shbutkhuzi/tank_volume_reporter/README.md

# Tank Volume Reporter
Device that tracks volume, temperature and the rate of change of volume in the tank and reports it via SMS

Repository contains two main directories

- Hardware
- Software

## Hardware

This directory describes hardware used in this project.

## Software

This directory contains two directories, one for bootloader and another for main application code. Each of them are described in their respective `README.md` files.
