shbutkhuzi/tank_volume_reporter/hardware/README.md

# Hardware

Following are main components of the hardware:

- STM32F103B8T6
> Microcontroller. **Note:** Board used here is Blue Pill, but the microcontroller is replaced with 128Kb version (B8T6)
- SIM800L
> GSM/GPRS module used for communication
- 24C32B
> EEPROM IC
- A02YYUW
> Ultrasonic distance sensor
- DS18B20
> Temperature sensor
- TP4056
> Lithium battery charing module
- MT3608
> DC-DC step up converter
- 18650 Lipo battery
> Just battery

## Photos of the module
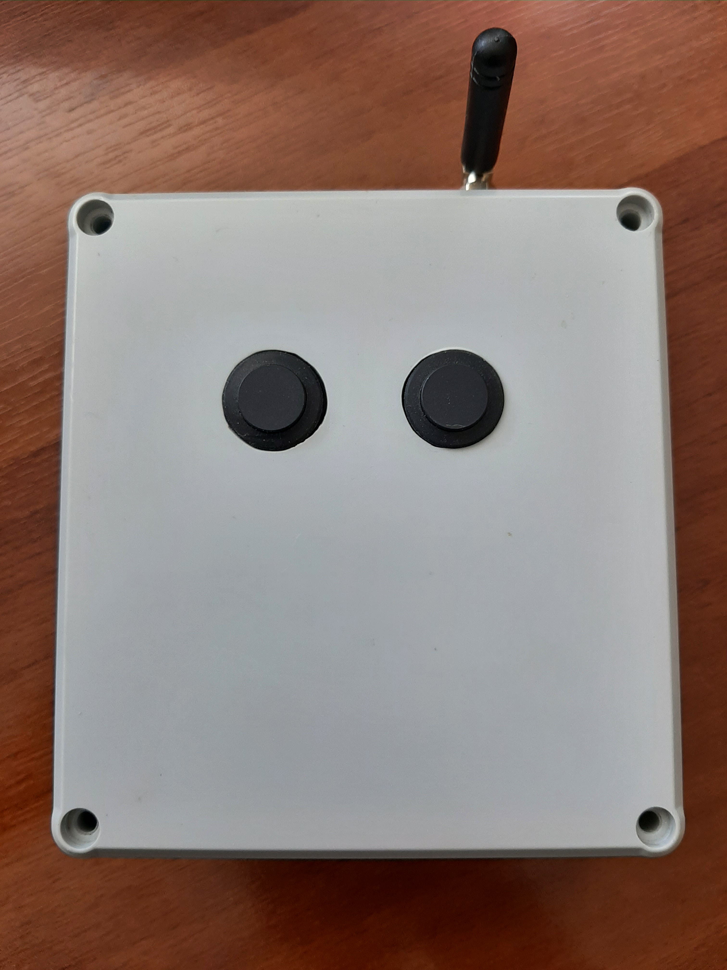
[picture p1: hardware/image_1.jpg]


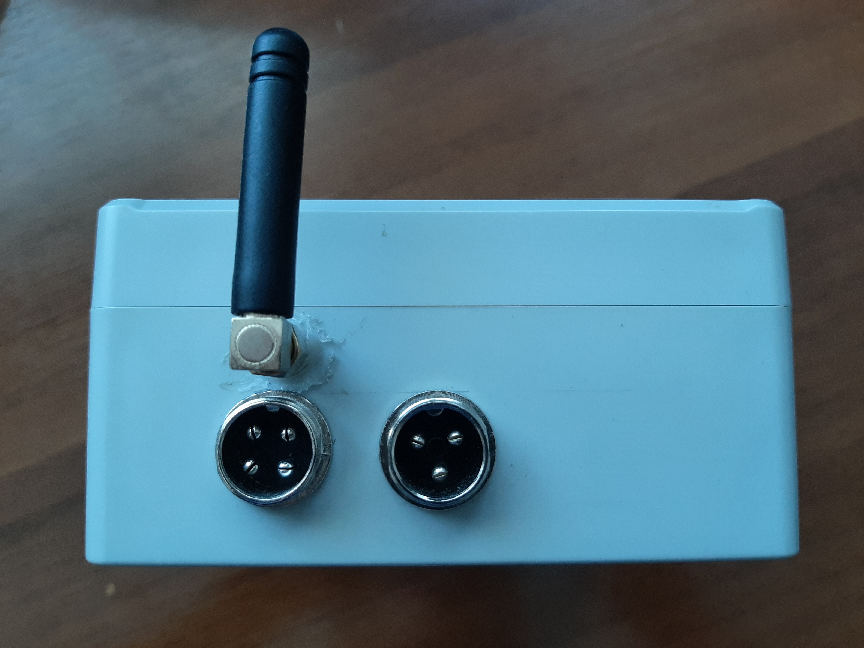
[picture p2: hardware/image_3.jpg]

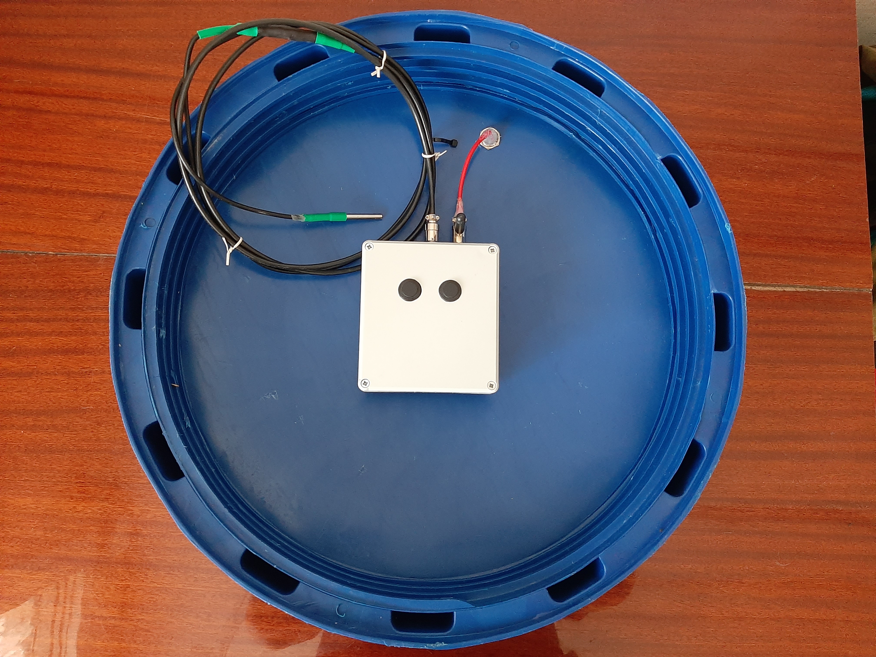
[picture p3: hardware/image_4.jpg]

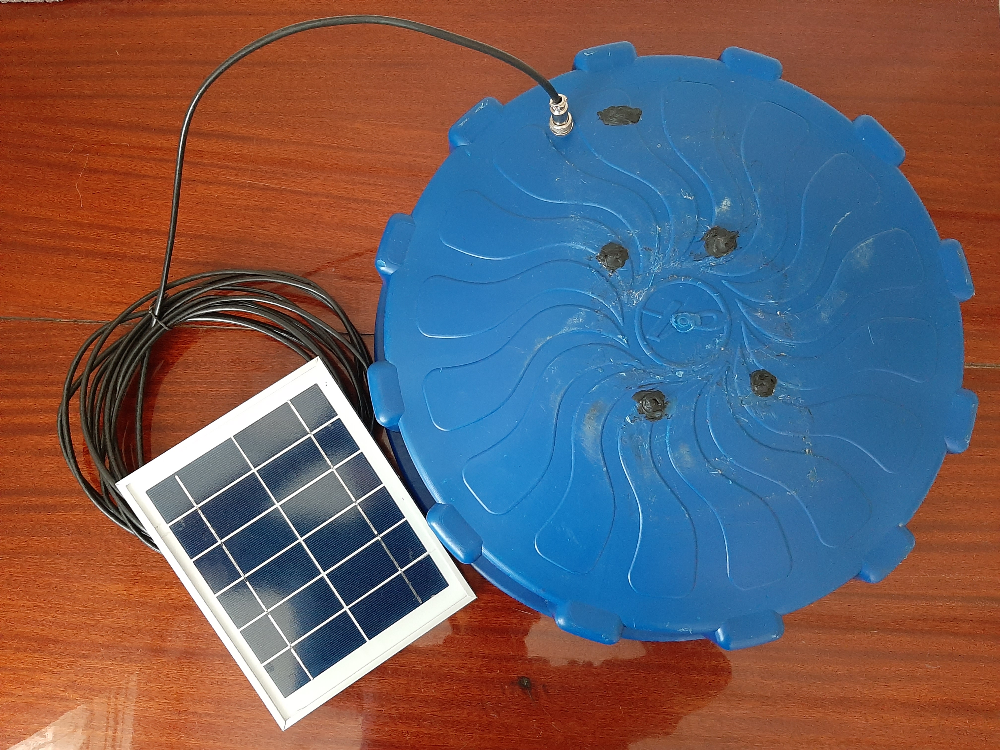
[picture p4: hardware/image_5.jpg]
