shbutkhuzi/tank_volume_reporter/software/README.md

# Software

Here are two directories each containing STM32 project made with the help of CubeIDE software

`application` directory contains main application code

`bootloader` directory contains the code used to update main appliaction code over the air
