shbutkhuzi/tank_volume_reporter/hardware/schematics.pdf

## MCU

MT3608

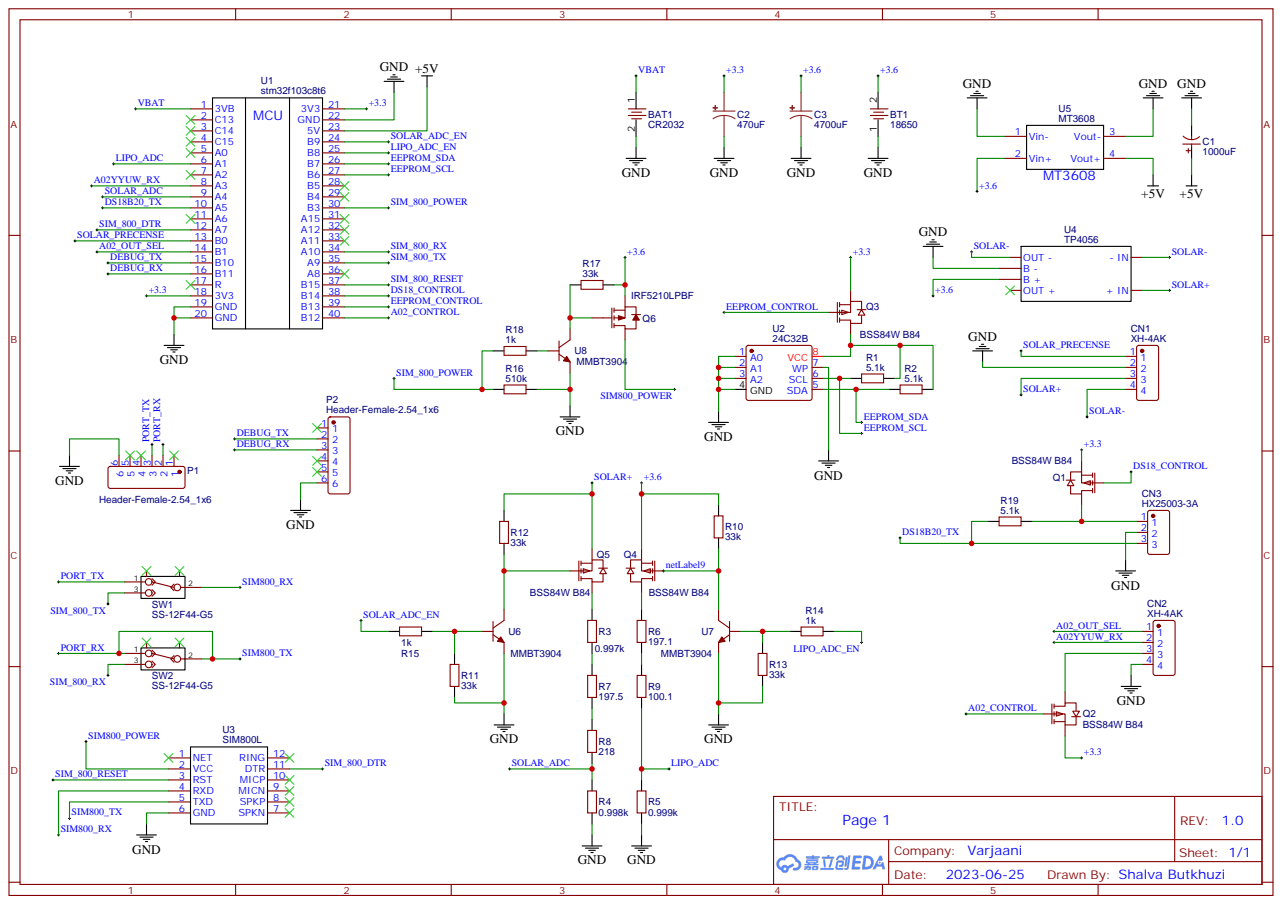
[picture p5: page 1]

Drawn By: Shalva Butkhuzi
