shbutkhuzi/tank_volume_reporter/software/application/application.ioc

Mcu.UserName=STM32F103C8Tx
PA1.GPIO_Label=LIPO_ADC
PA1.Signal=ADCx_IN1
PA10.GPIO_Label=SIM_800_RX
PA10.Signal=USART1_RX
PA13.Signal=SYS_JTMS-SWDIO
PA14.Signal=SYS_JTCK-SWCLK
PA2.GPIO_Label=A02YYUW_TX
PA2.Signal=USART2_TX
PA3.GPIO_Label=A02YYUW_RX
PA3.Signal=USART2_RX
PA4.GPIO_Label=SOLAR_ADC
PA4.Signal=ADCx_IN4
PA5.GPIO_Label=DS18B20_TX
PA5.Signal=GPIO_Output
PA7.GPIO_Label=SIM_800_DTR
PA7.Signal=GPIO_Output
PA9.GPIO_Label=SIM_800_TX
PA9.Signal=USART1_TX
PB0.GPIO_Label=SOLAR_PRESENSE
PB0.Signal=GPIO_Input
PB1.GPIO_Label=A02_OUT_SEL
PB1.Signal=GPIO_Output
PB10.GPIO_Label=DEBUG_TX
PB10.Signal=USART3_TX
PB11.GPIO_Label=DEBUG_RX
PB11.Signal=USART3_RX
PB12.GPIO_Label=A02_CONTROL
PB12.Signal=GPIO_Output
PB13.GPIO_Label=EEPROM_CONTROL
PB13.Signal=GPIO_Output
PB14.GPIO_Label=DS18_CONTROL
PB14.Signal=GPIO_Output
PB15.GPIO_Label=SIM_800_RESET
PB15.Signal=GPIO_Output
PB3.GPIO_Label=SIM_800_POWER
PB3.Signal=GPIO_Output
PB6.GPIO_Label=EEPROM_SCL
PB6.Signal=I2C1_SCL
PB7.GPIO_Label=EEPROM_SDA
PB7.Signal=I2C1_SDA
PB8.GPIO_Label=LIPO_ADC_EN
PB8.Signal=GPIO_Output
PB9.GPIO_Label=SOLAR_ADC_EN
PB9.Signal=GPIO_Output
PC13-TAMPER-RTC.GPIO_Label=LED
PC13-TAMPER-RTC.Signal=GPIO_Output
PC14-OSC32_IN.Signal=RCC_OSC32_IN
PC15-OSC32_OUT.Signal=RCC_OSC32_OUT
PD0-OSC_IN.Signal=RCC_OSC_IN
PD1-OSC_OUT.Signal=RCC_OSC_OUT
