shbutkhuzi/tank_volume_reporter/software/application/Core/Inc/main.h

#define LED_Pin GPIO_PIN_13
#define LED_GPIO_Port GPIOC
#define LIPO_ADC_Pin GPIO_PIN_1
#define LIPO_ADC_GPIO_Port GPIOA
#define A02YYUW_TX_Pin GPIO_PIN_2
#define A02YYUW_TX_GPIO_Port GPIOA
#define A02YYUW_RX_Pin GPIO_PIN_3
#define A02YYUW_RX_GPIO_Port GPIOA
#define SOLAR_ADC_Pin GPIO_PIN_4
#define SOLAR_ADC_GPIO_Port GPIOA
#define DS18B20_TX_Pin GPIO_PIN_5
#define DS18B20_TX_GPIO_Port GPIOA
#define SIM_800_DTR_Pin GPIO_PIN_7
#define SIM_800_DTR_GPIO_Port GPIOA
#define SOLAR_PRESENSE_Pin GPIO_PIN_0
#define SOLAR_PRESENSE_GPIO_Port GPIOB
#define A02_OUT_SEL_Pin GPIO_PIN_1
#define A02_OUT_SEL_GPIO_Port GPIOB
#define DEBUG_TX_Pin GPIO_PIN_10
#define DEBUG_TX_GPIO_Port GPIOB
#define DEBUG_RX_Pin GPIO_PIN_11
#define DEBUG_RX_GPIO_Port GPIOB
#define A02_CONTROL_Pin GPIO_PIN_12
#define A02_CONTROL_GPIO_Port GPIOB
#define EEPROM_CONTROL_Pin GPIO_PIN_13
#define EEPROM_CONTROL_GPIO_Port GPIOB
#define DS18_CONTROL_Pin GPIO_PIN_14
#define DS18_CONTROL_GPIO_Port GPIOB
#define SIM_800_RESET_Pin GPIO_PIN_15
#define SIM_800_RESET_GPIO_Port GPIOB
#define SIM_800_TX_Pin GPIO_PIN_9
#define SIM_800_TX_GPIO_Port GPIOA
#define SIM_800_RX_Pin GPIO_PIN_10
#define SIM_800_RX_GPIO_Port GPIOA
#define SIM_800_POWER_Pin GPIO_PIN_3
#define SIM_800_POWER_GPIO_Port GPIOB
#define EEPROM_SCL_Pin GPIO_PIN_6
#define EEPROM_SCL_GPIO_Port GPIOB
#define EEPROM_SDA_Pin GPIO_PIN_7
#define EEPROM_SDA_GPIO_Port GPIOB
#define LIPO_ADC_EN_Pin GPIO_PIN_8
#define LIPO_ADC_EN_GPIO_Port GPIOB
#define SOLAR_ADC_EN_Pin GPIO_PIN_9
#define SOLAR_ADC_EN_GPIO_Port GPIOB
