shbutkhuzi/tank_volume_reporter/(commit log)

2023-09-11 add admin command to restart device
2023-09-24 added data structures for storing threshold values, also disable EEPROM power off
2023-09-25 add cmd:update_user but buggy
    [EEPROM_data.c, Process_Data.c, client_subscription.c, client_subscription.h, main.c, main.h]
